TinyTapeout/tt_asw_1v8/mag/tt_asw_1v8.sim.spice

* NGSPICE file created from tt_asw_1v8_parax.ext - technology: sky130A

.subckt tt_asw_1v8_parax VGND VPWR mod bus ctrl
X0 VPWR.t28 ctrl.t0 a_264_2813.t0 VPWR.t27 sky130_fd_pr__pfet_01v8 ad=0.465 pd=3.62 as=0.2475 ps=1.83 w=1.5 l=0.15
X1 mod.t20 a_264_2813.t3 bus.t16 VPWR.t24 sky130_fd_pr__pfet_01v8_lvt ad=0.6525 pd=4.79 as=0.6525 ps=4.79 w=4.5 l=0.35
X2 bus.t17 a_264_2813.t4 mod.t19 VPWR.t23 sky130_fd_pr__pfet_01v8_lvt ad=0.6525 pd=4.79 as=0.6525 ps=4.79 w=4.5 l=0.35
X3 bus.t19 a_264_2813.t5 mod.t18 VPWR.t22 sky130_fd_pr__pfet_01v8_lvt ad=0.6525 pd=4.79 as=0.6525 ps=4.79 w=4.5 l=0.35
X4 bus.t12 a_264_2813.t6 mod.t17 VPWR.t21 sky130_fd_pr__pfet_01v8_lvt ad=0.6525 pd=4.79 as=0.6525 ps=4.79 w=4.5 l=0.35
X5 bus.t13 a_264_2813.t7 mod.t16 VPWR.t20 sky130_fd_pr__pfet_01v8_lvt ad=0.6525 pd=4.79 as=0.6525 ps=4.79 w=4.5 l=0.35
X6 bus.t14 a_264_2813.t8 mod.t15 VPWR.t19 sky130_fd_pr__pfet_01v8_lvt ad=0.6525 pd=4.79 as=0.6525 ps=4.79 w=4.5 l=0.35
X7 a_264_2813.t2 ctrl.t1 VPWR.t26 VPWR.t25 sky130_fd_pr__pfet_01v8 ad=0.2475 pd=1.83 as=0.465 ps=3.62 w=1.5 l=0.15
X8 mod.t27 a_680_3582# bus.t21 VGND.t8 sky130_fd_pr__nfet_01v8_lvt ad=0.6525 pd=4.79 as=0.6525 ps=4.79 w=4.5 l=0.35
X9 mod.t14 a_264_2813.t9 bus.t18 VPWR.t18 sky130_fd_pr__pfet_01v8_lvt ad=0.6525 pd=4.79 as=0.6525 ps=4.79 w=4.5 l=0.35
X10 mod.t13 a_264_2813.t10 bus.t20 VPWR.t17 sky130_fd_pr__pfet_01v8_lvt ad=0.6525 pd=4.79 as=0.6525 ps=4.79 w=4.5 l=0.35
X11 a_680_3582# a_264_2813.t11 VGND.t1 VGND.t0 sky130_fd_pr__nfet_01v8 ad=0.435 pd=3.58 as=0.435 ps=3.58 w=1.5 l=0.15
X12 mod.t12 a_264_2813.t12 bus.t15 VPWR.t16 sky130_fd_pr__pfet_01v8_lvt ad=0.6525 pd=4.79 as=1.305 ps=9.58 w=4.5 l=0.35
X13 bus.t22 a_680_3582# mod.t26 VGND.t7 sky130_fd_pr__nfet_01v8_lvt ad=0.6525 pd=4.79 as=0.6525 ps=4.79 w=4.5 l=0.35
X14 bus.t0 a_264_2813.t13 mod.t11 VPWR.t15 sky130_fd_pr__pfet_01v8_lvt ad=0.6525 pd=4.79 as=0.6525 ps=4.79 w=4.5 l=0.35
X15 VPWR.t14 a_264_2813.t14 a_680_3582# VPWR.t13 sky130_fd_pr__pfet_01v8 ad=0.465 pd=3.62 as=0.2475 ps=1.83 w=1.5 l=0.15
X16 mod.t10 a_264_2813.t15 bus.t1 VPWR.t12 sky130_fd_pr__pfet_01v8_lvt ad=0.6525 pd=4.79 as=0.6525 ps=4.79 w=4.5 l=0.35
X17 mod.t25 a_680_3582# bus.t26 VGND.t6 sky130_fd_pr__nfet_01v8_lvt ad=0.6525 pd=4.79 as=0.6525 ps=4.79 w=4.5 l=0.35
X18 mod.t9 a_264_2813.t16 bus.t2 VPWR.t11 sky130_fd_pr__pfet_01v8_lvt ad=0.6525 pd=4.79 as=0.6525 ps=4.79 w=4.5 l=0.35
X19 mod.t8 a_264_2813.t17 bus.t9 VPWR.t10 sky130_fd_pr__pfet_01v8_lvt ad=0.6525 pd=4.79 as=0.6525 ps=4.79 w=4.5 l=0.35
X20 mod.t24 a_680_3582# bus.t27 VGND.t5 sky130_fd_pr__nfet_01v8_lvt ad=0.6525 pd=4.79 as=0.6525 ps=4.79 w=4.5 l=0.35
X21 a_264_2813.t1 ctrl.t2 VGND.t10 VGND.t9 sky130_fd_pr__nfet_01v8 ad=0.435 pd=3.58 as=0.435 ps=3.58 w=1.5 l=0.15
X22 bus.t7 a_264_2813.t18 mod.t7 VPWR.t9 sky130_fd_pr__pfet_01v8_lvt ad=0.6525 pd=4.79 as=0.6525 ps=4.79 w=4.5 l=0.35
X23 bus.t8 a_264_2813.t19 mod.t6 VPWR.t8 sky130_fd_pr__pfet_01v8_lvt ad=0.6525 pd=4.79 as=0.6525 ps=4.79 w=4.5 l=0.35
X24 a_680_3582# a_264_2813.t20 VPWR.t7 VPWR.t6 sky130_fd_pr__pfet_01v8 ad=0.2475 pd=1.83 as=0.465 ps=3.62 w=1.5 l=0.15
X25 bus.t10 a_264_2813.t21 mod.t5 VPWR.t5 sky130_fd_pr__pfet_01v8_lvt ad=0.6525 pd=4.79 as=0.6525 ps=4.79 w=4.5 l=0.35
X26 mod.t4 a_264_2813.t22 bus.t3 VPWR.t4 sky130_fd_pr__pfet_01v8_lvt ad=1.305 pd=9.58 as=0.6525 ps=4.79 w=4.5 l=0.35
X27 mod.t3 a_264_2813.t23 bus.t4 VPWR.t3 sky130_fd_pr__pfet_01v8_lvt ad=0.6525 pd=4.79 as=0.6525 ps=4.79 w=4.5 l=0.35
X28 bus.t25 a_680_3582# mod.t23 VGND.t4 sky130_fd_pr__nfet_01v8_lvt ad=0.6525 pd=4.79 as=0.6525 ps=4.79 w=4.5 l=0.35
X29 bus.t5 a_264_2813.t24 mod.t2 VPWR.t2 sky130_fd_pr__pfet_01v8_lvt ad=0.6525 pd=4.79 as=0.6525 ps=4.79 w=4.5 l=0.35
X30 bus.t24 a_680_3582# mod.t22 VGND.t3 sky130_fd_pr__nfet_01v8_lvt ad=0.6525 pd=4.79 as=1.305 ps=9.58 w=4.5 l=0.35
X31 bus.t23 a_680_3582# mod.t21 VGND.t2 sky130_fd_pr__nfet_01v8_lvt ad=1.305 pd=9.58 as=0.6525 ps=4.79 w=4.5 l=0.35
X32 mod.t1 a_264_2813.t25 bus.t11 VPWR.t1 sky130_fd_pr__pfet_01v8_lvt ad=0.6525 pd=4.79 as=0.6525 ps=4.79 w=4.5 l=0.35
X33 mod.t0 a_264_2813.t26 bus.t6 VPWR.t0 sky130_fd_pr__pfet_01v8_lvt ad=0.6525 pd=4.79 as=0.6525 ps=4.79 w=4.5 l=0.35
R0 ctrl.n1 ctrl.t0 317.212
R1 ctrl.t0 ctrl.n0 317.212
R2 ctrl.n1 ctrl.t1 317.185
R3 ctrl.t1 ctrl.n0 317.185
R4 ctrl.n3 ctrl.t2 231.677
R5 ctrl.n2 ctrl.n1 68.35
R6 ctrl.n2 ctrl.n0 66.8028
R7 ctrl ctrl.n3 9.07858
R8 ctrl.n3 ctrl.n2 0.387869
R9 a_264_2813.n9 a_264_2813.t22 515.574
R10 a_264_2813.n4 a_264_2813.t22 515.574
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
R360 VGND VGND.n39 0.024
C0 mod bus 23.4702f
C1 VPWR ctrl 1.07021f
C2 VPWR mod 1.79432f
C3 mod ctrl 0.052081f
C4 a_680_3582# bus 0.687796f
C5 VPWR a_680_3582# 1.08351f
C6 a_680_3582# ctrl 0.167494f
C7 mod a_680_3582# 1.35103f
C8 VPWR bus 1.99929f
C9 bus ctrl 0.007757f
.ends
