TinyTapeout/tt_asw_1v8/(commit log)

2024-03-21 updated with Haralds suggestions
    [tt_asw_1v8.sch]
2024-03-21 layout done, lvs fail due to multi finger fet
2024-03-23 xschem: Improve transistor parameters
    * Reduce the digital transistor size a bit
    * Switch the analog transistors to Low-Vt variants
    * Increase channel length to 0.5
    * Adapt W/nf to get better Rds_on and better P/N matching
    [tt_asw_1v8.sch]
2024-03-23 xschem: Add a testbench to check Rds_on
    [tb_rdson.sch]
2024-04-04 add vsweep for resistance
    [testbench.sch]
2024-04-04 add ac analysis
    [testbench.sch]
2024-04-05 mag: Layout update for new schematic
2024-04-06 new sims with parax
    [testbench.sch]
2024-04-07 xschem: Don't use the nf variants in schematic and use better W/L/nf
    The nf variant is a trap since the W is _per_finger_ ... so our
    layout wasn't matching the sim.
    Redid some dimensionning using the normal variant which has W being
    the total width. That requires much bigger transistor to get comparable
    specs.
    [tt_asw_1v8.sch]
2024-04-07 removed the -d option to ext2spice in the tcl removed a graph and set limits on the ac bandwidth
    [testbench.sch]
